david95dx/Bomba-Peristaltica/MEDIA/IMG_20180118_224628.jpg

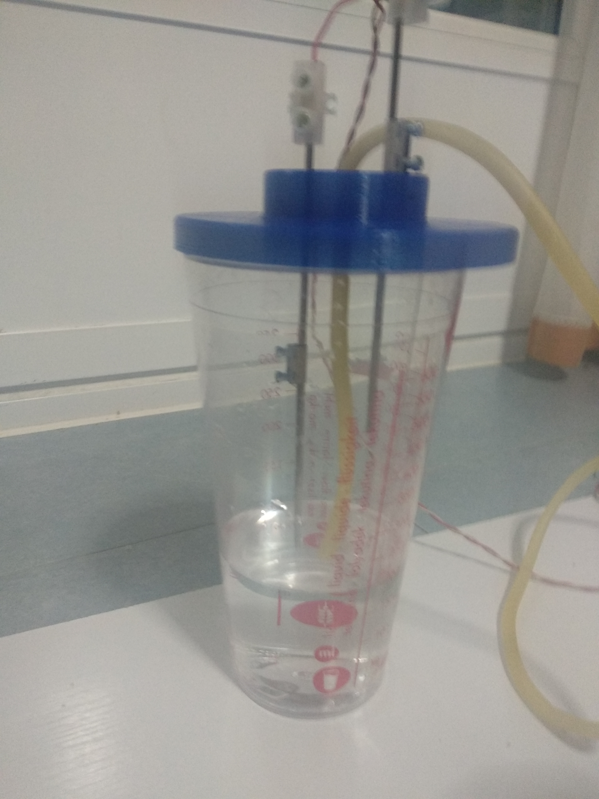
MEDIA/IMG_20180118_224628.jpg
