david95dx/Bomba-Peristaltica/MEDIA/IMG_20180117_201114_HDR.jpg

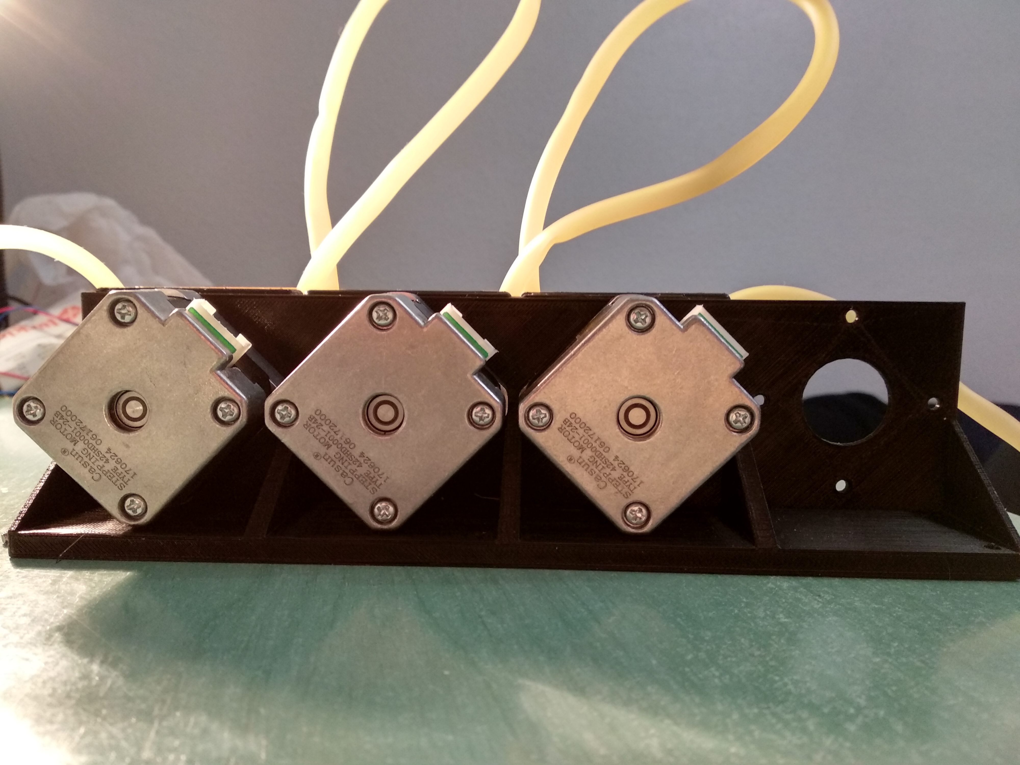
MEDIA/IMG_20180117_201114_HDR.jpg
