david95dx/Bomba-Peristaltica/STL/whole_assembly.stl

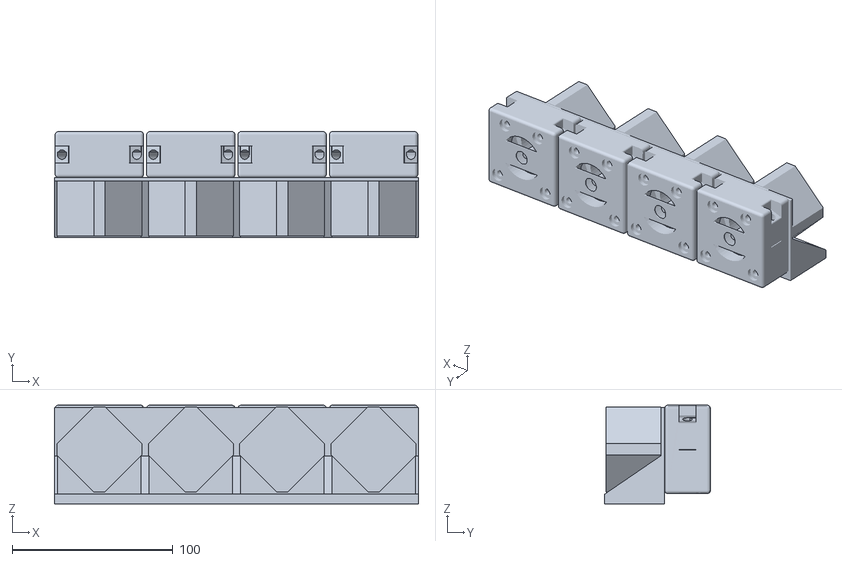
[picture p3: CAD file, 2018-02-02]
STL/whole_assembly.stl
226.3 x 65.8 x 61.4
