david95dx/Bomba-Peristaltica/STL/Bearing_Mount_Bottom.stl

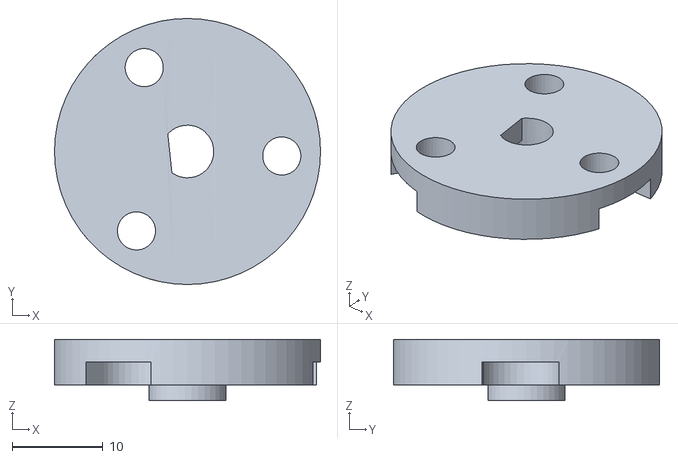
[picture p4: CAD file, 2018-02-02]
STL/Bearing_Mount_Bottom.stl
29.3 x 29.3 x 6.75
