david95dx/Bomba-Peristaltica/STL/Single_Pump_Mount.stl

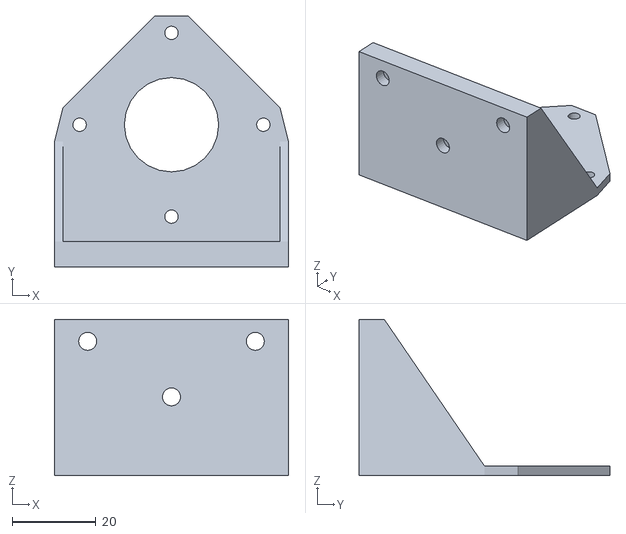
[picture p5: CAD file, 2018-02-02]
STL/Single_Pump_Mount.stl
55.8 x 59.8 x 37.3
