david95dx/Bomba-Peristaltica/STL/Hose_Pressure_Plate.stl

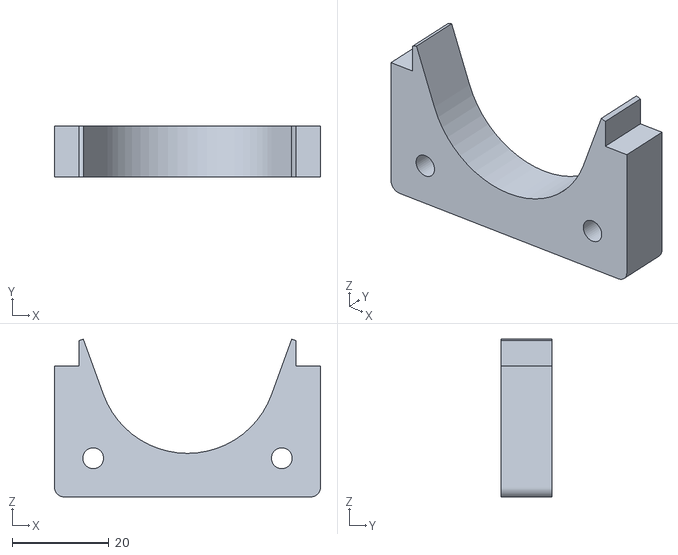
[picture p6: CAD file, 2018-02-02]
STL/Hose_Pressure_Plate.stl
55.0 x 10.5 x 32.6
