david95dx/Bomba-Peristaltica/STL/Pump_Top.stl

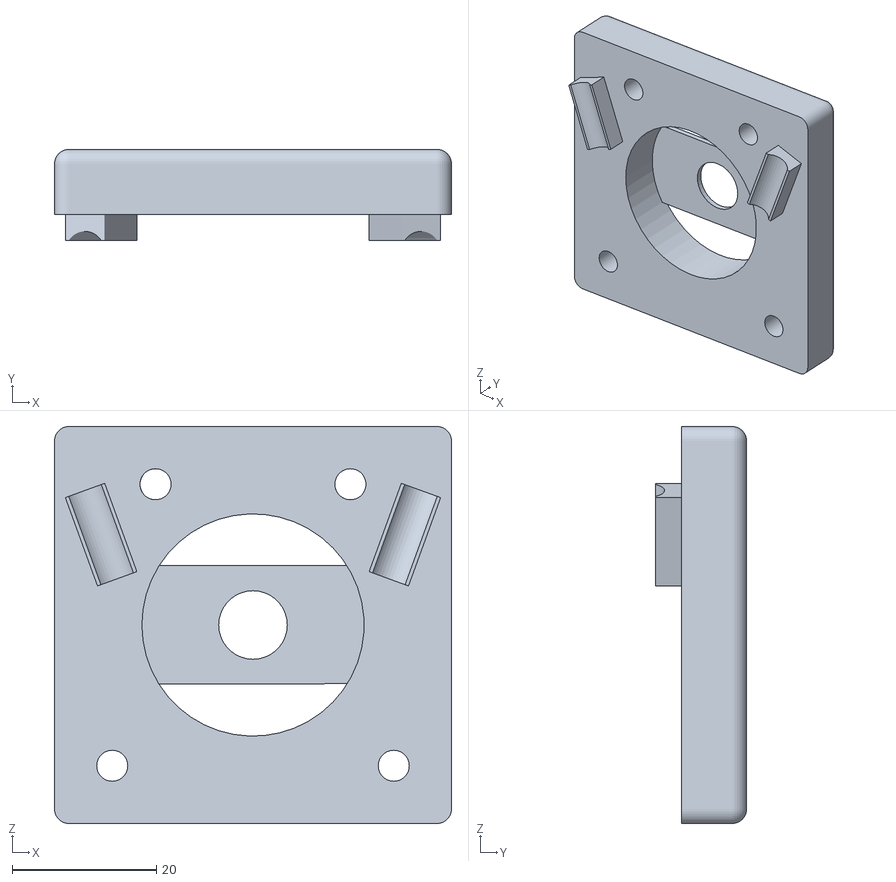
[picture p7: CAD file, 2018-02-02]
STL/Pump_Top.stl
55.0 x 12.6 x 55.0
