david95dx/Bomba-Peristaltica/STL/Pump_Base.stl

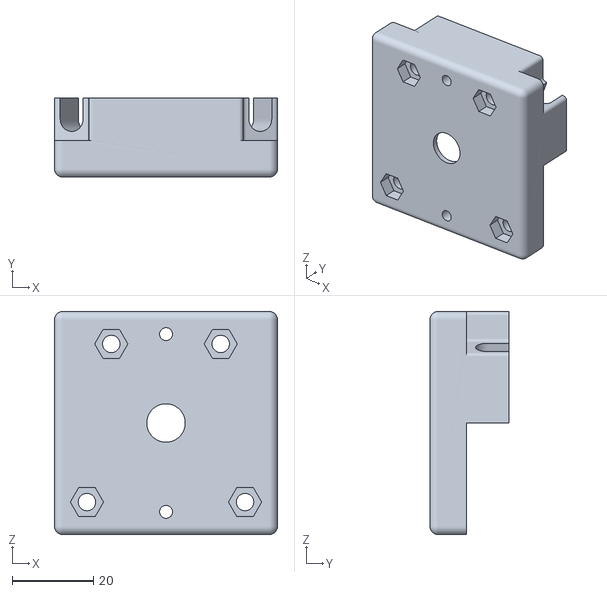
[picture p8: CAD file, 2018-02-02]
STL/Pump_Base.stl
55.0 x 19.5 x 55.0
