david95dx/Bomba-Peristaltica/STL/Mountng_Bracket.stl

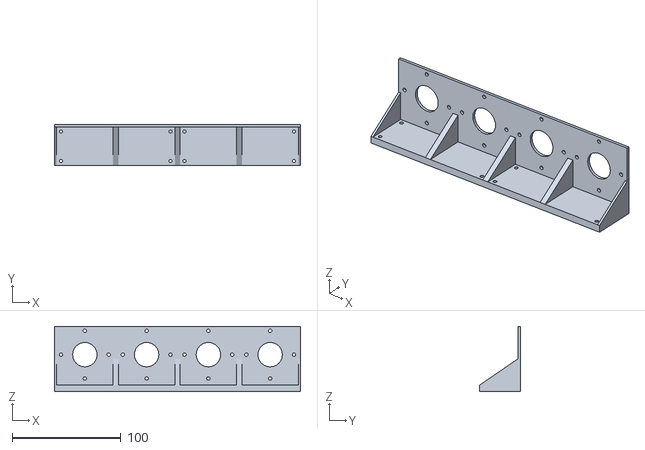
[picture p9: CAD file, 2018-02-02]
STL/Mountng_Bracket.stl
226.3 x 37.3 x 59.8
