david95dx/Bomba-Peristaltica/STL/Motor_Spacer_Plate.stl

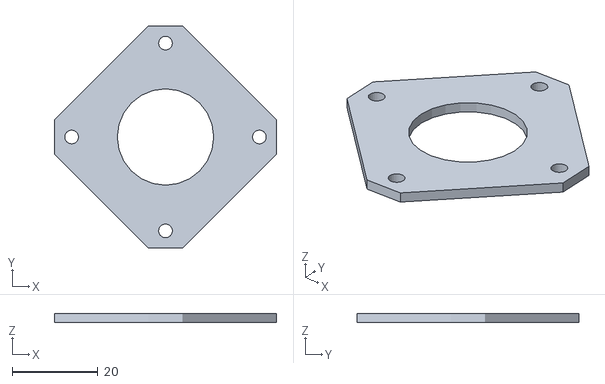
[picture p10: CAD file, 2018-02-02]
STL/Motor_Spacer_Plate.stl
51.8 x 51.8 x 2.00
