david95dx/Bomba-Peristaltica/STL/bearing_washer.stl

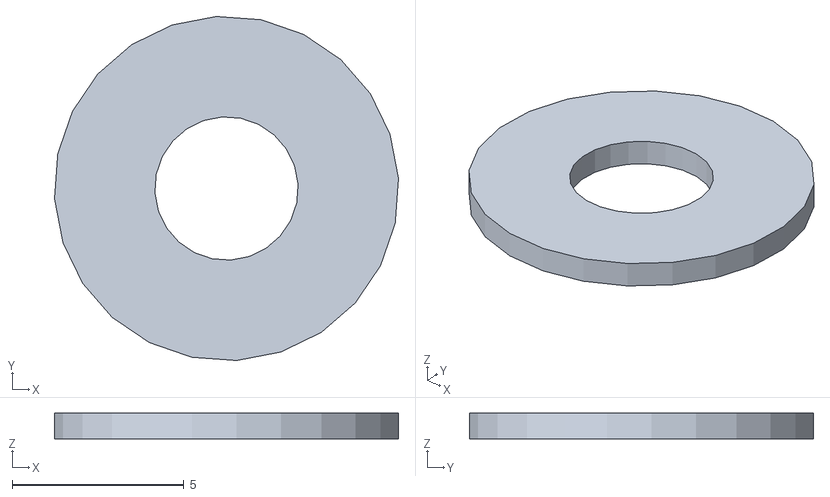
[picture p11: CAD file, 2018-02-02]
STL/bearing_washer.stl
10.0 x 10.0 x 0.75
