david95dx/Bomba-Peristaltica/(list of files, cad)

Other CAD files:
STL/Bearing_Mount_top.stl
